liuxinyang1984/openscad/readme.md

1. 对丝的对接厚度
    > 商家:长度是40mm,中间厚度为8mm
    > 考虑对接,我们按照10mm设计
2.三通的对接长度,如10cm+三通+10cm 对接起来的长度是多少?
    > 商家: 三通两头长度 52mm,单头26mm
    > 对接螺纹按10mm设计,所有三通出通,单头要留16mm
    > 两根100mmDN15,对接后长度应该为232mm
2. 确认桌子长宽高度
3. 确认电脑机箱高度是否合适
