liuxinyang1984/openscad/desk_iso.png

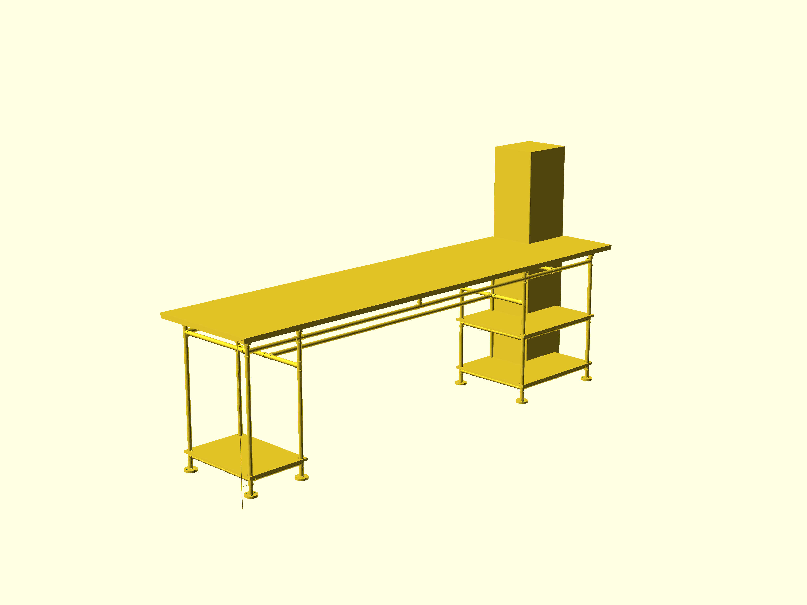
desk_iso.png
