liuxinyang1984/openscad/desk_iso_color.png

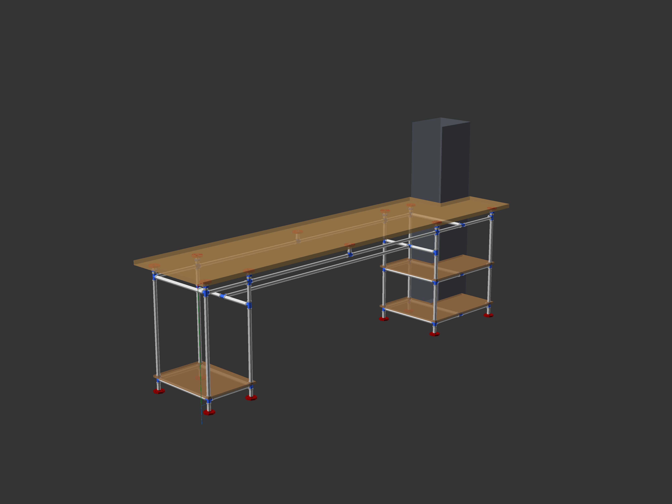
desk_iso_color.png
