liuxinyang1984/openscad/panel_plans.png

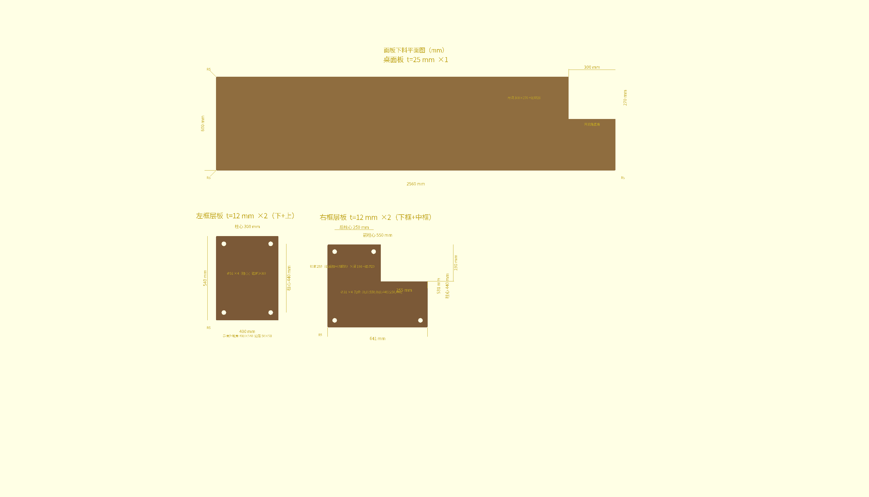
panel_plans.png
