liuxinyang1984/openscad/shelf_panel_plans.png

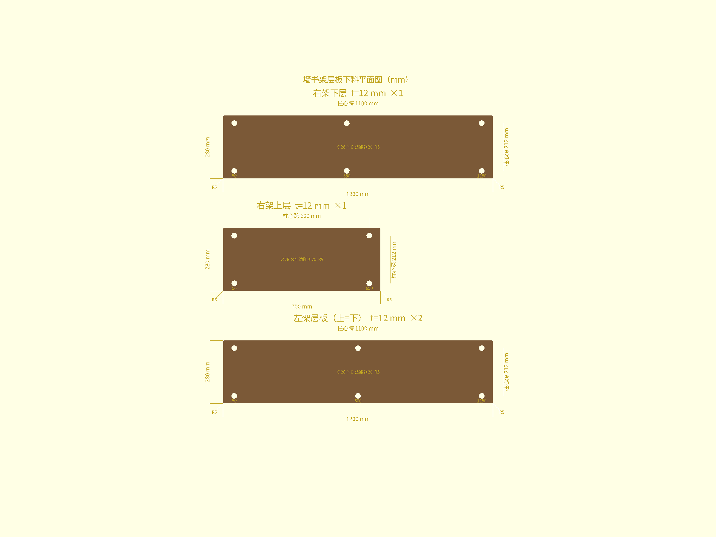
shelf_panel_plans.png
