liuxinyang1984/openscad/reference/pre-redesign/bom.md

# 桌架物料清单（BOM）

> 管件标准：**DN15**。  
> **直管下料均为整厘米（xxx0 mm）**：切断该长度后 **两端套丝**（按每端有效螺纹 14 mm 计，模型净直段 ≈ **下料 − 28**）。  
> **管件搭接（商家实测）**：三通/四通/五通主通 **52 mm**（单头 **26 mm**），螺纹拧入约 **10 mm** → 算净直段时每端占 **16 mm**（`fittingHeadExtraMm`）。

| 参数 | 值 |
|---|-----|
| 桌面总高 | **700** mm |
| **桌面左右宽** | **2000** mm |
| 桌深 | **700** mm |
| 单框柱心距 X | **284 mm**（横拉净 252 + 2×16） |
| 单框柱心距 Y | **594 mm**（纵拉净 562 + 2×16） |

参数源：`table_module.scad` 中 `rfCut*` / `lfCut*` / `deskCross*` / `fittingHeadExtraMm`。

---

## 总 BOM 汇总（右框 + 左框 + 左右拉结，1 桌）

### 连接件

| 序号 | 名称 | 规格 | 右框 | 左框 | **合计** |
|---|---|---|---|---|---|
| T-01 | 三孔内丝镀锌法兰 | DN15 | 8 | 8 | **16** + 拉结 **1** = **17** |
| T-02 | 立体四通 | DN15 | 8 | 10 | **18** |
| T-03 | 立体五通 | DN15 | — | 2 | **2** |
| T-04 | 平面三通 | DN15 | 3 | 3 | **6** + 拉结 **1** = **7** |
| T-05 | 对丝（成品，不切断） | DN15，长 40 | 4 | 4 | **8** + 拉结 **1** = **9** |

### 直管下料（全部 xxx0 mm）

| 序号 | 用途 | **下料** | 右框 | 左框 | 拉结 | **根数** | **下料小计 (mm)** |
|---|---|---|---|---|---|---|---|
| T-10 | 脚高短立管（四角） | **80** | 4 | 4 | — | **8** | 640 |
| T-11 | 下半框立管（下四通→上四通） | **220** | 4 | — | — | **4** | 880 |
| T-12 | 下半框立管（左框 z_hi 层） | **400** | — | 4 | — | **4** | 1600 |
| T-13 | 上半衔接短立管（右框四角） | **380** | 4 | — | — | **4** | 1520 |
| T-14 | 上半衔接短立管（左框反算） | **180** | — | 4 | — | **4** | 720 |
| T-15 | 前后横拉（沿 X） | **280** | 6 | 6 | — | **12** | 3360 |
| T-16 | 左右纵拉（沿 Y） | **590** | 6 | 6 | — | **12** | 7080 |
| T-17 | 缘垂挂下段（左/右缘） | **120** | 2 | 2 | — | **4** | 480 |
| T-18 | 缘深向半跨（左/右缘，反算） | **300** | 2 | 2 | — | **4** | 1200 |
| T-19 | 前拉结半管（前缘，中点对半） | **720** | — | — | **2** | 1440 |
| T-20 | 中/后拉结整管 | **1400** | — | — | **2** | 2800 |
| T-21 | 前拉结支口竖管（三通→法兰，@ z_top） | **50** | — | — | **1** | 50 |

| | |
|--|--|
| **直管总根数** | **61** |
| **直管下料总长** | **21770 mm（21.77 m）** |
| 法兰 T-01 | **17** |
| 平面三通 T-04 | **7** |
| 对丝 T-05 | **9** |
| 四通/五通 | **20** |

### 直管下料 → 模型净长（约）

| 下料 (mm) | 净直段 (mm) | 总根数 |
|---|---|---|
| 50 | 22 | 1 |
| 80 | 52 | 8 |
| 120 | 92 | 4 |
| 180 | 152 | 4 |
| 220 | 192 | 4 |
| 280 | 252 | 12 |
| 300 | 272 | 4 |
| 380 | 352 | 4 |
| 400 | 372 | 4 |
| 590 | 562 | 12 |
| 720 | 692 | 2 |
| 1400 | 1372 | 2 |

> **T-19 / T-21**：**前缘**横管 @ **z_top**（≈ **632 mm**，与柱顶五通/四通主通同高），中点三通 + 支口至桌面底。  
> **T-20（中）**：**deskCrossMidRowZMm**（≈ **552 mm**）**整根**拉结。 **T-20（后）**：**z_top** 整根。

---

## 右框架（1 套）

### 连接件

| 序号 | 名称 | 规格 | 数量 |
|---|---|---|---|
| R-01 | 三孔内丝镀锌法兰 | DN15 | 8 |
| R-02 | 立体四通 | DN15 | 8 |
| R-03 | 平面三通 | DN15 | 3 |
| R-04 | 对丝（成品） | DN15，长 40 | 4 |

### 直管下料（全部 xxx0 mm）

| 序号 | 用途 | **下料** | 数量 | 小计 (mm) |
|---|---|---|---|---|
| R-10 | 脚高短立管（四角） | **80** | 4 | 320 |
| R-11 | 下半框立管（下四通→上四通） | **220** | 4 | 880 |
| R-12 | 上半衔接短立管（四角） | **380** | 4 | 1520 |
| R-13 | 前后横拉（沿 X，z_lo / z_hi / 顶层） | **280** | 6 | 1680 |
| R-14 | 左右纵拉（沿 Y，z_lo / z_hi / 顶层） | **590** | 6 | 3540 |
| R-15 | 左缘垂挂下段 | **120** | 2 | 240 |
| R-16 | 左缘深向半跨（反算） | **300** | 2 | 600 |

**直管合计**：28 根，**8780 mm**（8.78 m，未含锯缝）。

| 下料 | 模型净直段（约） |
|---|---|
| 80 | 52 |
| 220 | 192 |
| 380 | 352 |
| 280 | 252 |
| 590 | 562 |
| 120 | 92 |
| 300 | 272 |

---

## 左框架（1 套）

> 相对右框：下部框 **z_hi 上圈四横管**抬高（`lfCutLowerShelfVertMm = 400`）；右前/右后顶托为 **五通**。

### 连接件

| 序号 | 名称 | 规格 | 数量 | 相对右框 |
|---|---|---|---|---|
| L-01 | 三孔内丝镀锌法兰 | DN15 | 8 | 同 R-01 |
| L-02 | 立体四通 | DN15 | 10 | 下框 8 + 顶 2 |
| L-03 | 立体五通 | DN15 | 2 | 右前/右后顶 |
| L-04 | 平面三通 | DN15 | 3 | 同 R-03 |
| L-05 | 对丝（成品） | DN15，长 40 | 4 | 同 R-04 |

### 直管下料（全部 xxx0 mm）

| 序号 | 用途 | **下料** | 数量 | 小计 (mm) | 右框对照 |
|---|---|---|---|---|---|
| L-10 | 脚高短立管（四角） | **80** | 4 | 320 | R-10 |
| L-11 | 下半框立管（撑 z_hi 四横管） | **400** | 4 | 1600 | R-11 **220** |
| L-12 | 上半衔接短立管（四角，反算） | **180** | 4 | 720 | R-12 **380** |
| L-13 | 前后横拉（沿 X） | **280** | 6 | 1680 | R-13 |
| L-14 | 左右纵拉（沿 Y） | **590** | 6 | 3540 | R-14 |
| L-15 | 右缘垂挂下段 | **120** | 2 | 240 | R-15 |
| L-16 | 右缘深向半跨（反算） | **300** | 2 | 600 | R-16 |

**直管合计**：28 根，**8700 mm**（8.70 m，未含锯缝）。

| 下料 | 模型净直段（约） |
|---|---|
| 80 | 52 |
| 400 | 372 |
| 180 | 152 |
| 280 | 252 |
| 590 | 562 |
| 120 | 92 |
| 300 | 272 |

> **L-12** 随 `lfCutLowerShelfVertMm` 与 `fittingHeadExtraMm` 反算；改 L-11 后请重开模型查 `lfCutStemMm`（须 xxx0）。

---

## 左右拉结（1 套）

> **前缘**：**z_top** 与左右柱顶 **五通** 主通同高，中点 **三通** + 支口 **直通 + 法兰 + 对丝**。  
> **中间**：**deskCrossMidRowZMm**（≈552 mm）**整根**。 **后缘**：**z_top** 整根。

### 连接件

| 序号 | 名称 | 规格 | 数量 |
|---|---|---|---|
| D-F1 | 平面三通 | DN15 | **1** |
| D-F2 | 三孔内丝镀锌法兰 | DN15 | **1** |
| D-F3 | 对丝（成品） | DN15，长 40 | **1** |

### 直管下料

| 序号 | 用途 | **下料** | 数量 | 小计 (mm) |
|---|---|---|---|---|
| D-10 | 前拉结半管（前缘） | **720** | 2 | 1440 |
| D-11 | 中/后拉结整管 | **1400** | 2 | 2800 |
| D-12 | 支口竖管（三通→法兰，@ z_top） | **50** | 1 | 50 |

改桌宽：调 **`table_width`**；`deskCrossHalfCutMm` / `deskCrossCutMm` 自动 xxx0。

---

## 分项合计（直管）

| 分项 | 根数 | 下料总长 (mm) |
|---|---|---|
| 右框架 | 28 | 8780 |
| 左框架 | 28 | 8700 |
| 左右拉结 | 5 | 4290 |
| **总 BOM** | **61** | **21770**（21.77 m） |

---

*生成依据：`table_module.scad`（前缘 **720**×2 + 支口 @ z_top；中 **1400** @ ≈552；后 **1400** @ z_top）。*
