liuxinyang1984/openscad/bom.md

# 物料清单（BOM）

> 按当前模型重算（桌子开口骨架 + 墙书架）。  
> 管件标准：**DN15**。  
> **搭接**：直管两端停在管件搭接外缘；净长 = 柱心距 − `2 × fittingHeadExtraMm`（16）。  
> **下料**：`ceil((净长 + 2 × threadEngageMm) / 10) × 10`（两端套丝各 10，整厘米 xx0）。  
> 参数源：`table/*`、`shelf/*`、`common/standards.scad`。

---

## 一、桌子（右框 + 左框 + 对接）

| 参数 | 值 |
|---|-----|
| 桌面板 | **2560 × 600 × 25** mm（右后开洞 300×270 + 过切 20；圆角 R5） |
| 骨架跨距 X | **2260** mm |
| 桌深 / 框深柱心 | **600** / **440** mm |
| 桌面底高 / 顶高 | **740** / **765** mm |
| 右框前跨 / 右移 / 底框高 | **550** / **300** / **350** mm |
| 左框宽 | **300** mm |
| `rf_z_lo` / `rf_z_hi` / `crossTieZ` | **86** / **350** / **542** mm |
| 左柜托板 | **400 × 540 × 12** mm ×2（孔边距 ≥30；孔径 ≈30.6；R5） |
| 右柜托板外包 | **≈641 × 531 × 12** mm ×2（右后切边自右后柱+outset≈45 起；同孔径/圆角） |

### 连接件

| 序号 | 名称 | 规格 | 右框 | 左框 | 对接 | **合计** |
|---|---|---|---|---|---|---|
| T-01 | 三孔内丝镀锌法兰 | DN15 | 8 | 8 | 1 | **17** |
| T-02 | 立体四通 | DN15 | 8 | — | — | **8** |
| T-03 | 平面三通 | DN15 | 3 | 9 | 1 | **13** |
| T-04 | 对丝 | DN15，长 40 | — | — | — | **0** |

> 底圈前缘已改为**整根**横管，无分叉三通。  
> 对接中点：**三通 + 短管 + 法兰**顶桌底（无对丝）。

### 直管下料（套丝前切断长度，xx0 mm）

| 序号 | 用途 | **下料** | 右 | 左 | 对接 | **根数** | 小计 (mm) |
|---|---|---|----|----|---|---|---|
| T-10 | 脚高短立管 | **80** | 4 | 4 | — | **8** | 640 |
| T-11 | 右框左缘：中框→拉结三通 | **180** | 2 | — | — | **2** | 360 |
| T-12 | 四柱垂挂上段→顶法兰（左右同长） | **200** | 2 | 4 | — | **6** | 1200 |
| T-13 | 缘深向半跨（左/右框朝桌心缘） | **210** | 2 | 2 | — | **4** | 840 |
| T-14 | 对接中托支口（三通→桌底法兰） | **210** | — | — | 1 | **1** | 210 |
| T-15 | 右框底圈后缘横拉 | **240** | 1 | — | — | **1** | 240 |
| T-16 | 右框中立管（下四通→中四通） | **260** | 4 | — | — | **4** | 1040 |
| T-17 | 左框底圈 X 横拉（前+后） | **290** | — | 2 | — | **2** | 580 |
| T-18 | 右框右缘上段→顶法兰 | **390** | 2 | — | — | **2** | 780 |
| T-19 | 左框左缘 crossTieZ 纵管 | **430** | — | 1 | — | **1** | 430 |
| T-20 | 左框四柱：底三通→拉结三通 | **450** | — | 4 | — | **4** | 1800 |
| T-21 | 右框底圈前缘整根 | **540** | 1 | — | — | **1** | 540 |
| T-22 | 对接半跨（柱↔中点三通）×2 | **770** | — | — | 2 | **2** | 1540 |

| | |
|--|--|
| **直管总根数** | **38** |
| **直管下料总长** | **10200 mm（10.20 m）**（未含锯缝） |

### 按下料长度汇总（桌）

| 下料 (mm) | 净直段（≈下料−20） | 根数 | 用途摘要 |
|---|---|---|---|
| 80 | 60 | 8 | 脚管 |
| 180 | 160 | 2 | 右框左缘垂挂下段 |
| 200 | 180 | 6 | 垂挂上段→法兰 |
| 210 | 190 | 5 | 缘半跨 ×4 + 对接中托 ×1 |
| 240 | 220 | 1 | 右框底后横 |
| 260 | 240 | 4 | 右框中立管 |
| 290 | 270 | 2 | 左框底 X |
| 390 | 370 | 2 | 右框右缘→法兰 |
| 430 | 410 | 1 | 左框左缘纵管 |
| 450 | 430 | 4 | 左框立柱下段 |
| 540 | 520 | 1 | 右框底前整根 |
| 770 | 750 | 2 | 对接半跨 |

### 木板（桌）

| 名称 | 厚度 | 数量 | 说明 |
|---|---|---|---|
| 桌面板 | 25 | 1 | 2560×600；右后开洞；三圆角 R5 |
| 左柜托板 | 12 | **2** | 外轮廓 **400×540**；∅≈30.6 孔×4；四角 R5 |
| 右柜托板 | 12 | **2** | 外包 ≈641×531；右后切宽≈255（柱+outset 起切）；同孔径/圆角 |

下料平面图：`panel_plans.svg` / `table/panel_plans.scad`。

### 右框架要点

- 底圈：前横**整根**（净 518 / 下料 540）+ 后横；**无左右纵管、无前缘分叉三通**
- 中圈 / 顶圈：无横纵管；中层板承在 `rf_z_hi` 立体四通
- 顶：立管 / 垂挂管直通翻法兰（无顶四通、无对丝）
- 左缘垂挂：半跨×2 + 中位三通（接对接）

### 左框架要点

- 底圈：仅前/后 X；底口均为三通
- `crossTieZ`：左缘整根 + 右缘半跨与中三通
- 托板 ×2：下 @ `lf_z_lo`，上 @ `crossTieZ`

### 对接要点

- 仅中位 @ `crossTieZ`：半跨 770×2 + 中托支口 210 + 三通 + 法兰
- 前/后顶层对接暂无

---

## 二、墙书架（右架 1200/700 + 左架 1200/1200）

| 参数 | 值 |
|---|-----|
| 层板深 / 厚 / 圆角 | **280** / **12** / **R5** |
| 格内净高 | **340** mm |
| 下层板顶 Z | **1565**（相对桌面顶 765 → 净空至板底 **788**） |
| 右架板长 | 下 **1200** / 上 **700** |
| 左架板长 | 上=下 **1200** ×2 |
| 层深管 | 净 **180** / 下料 **200**（整厘米取整） |
| 立管 | 净 **320** / 下料 **340** |
| 端柱上口 | **对丝 + 堵头**（已取消短管） |

> 当前模型侧框已装；柱间 X 向横拉管**尚未建模**（BOM 不含）。  
> 侧框几何以最右柱 `shelf_side_frame` 为基准 ×6（右 3 + 左 3）。

### 连接件（书架）

| 名称 | 规格 | 每柱 | ×6 | **合计** |
|---|---|---|-----|---|
| 三孔内丝镀锌法兰 | DN15 | 1 | 6 | **6** |
| 对丝 | DN15，长 40 | 3 | 6 | **18** |
| 平面四通（十字） | DN15 | 1 | 6 | **6** |
| 平面三通 | DN15 | 1 | 6 | **6** |
| 内丝堵头 | DN15 | 4 | 6 | **24** |

> 每柱对丝：墙锚 1 + 端柱上口前后各 1（**取代原短管**）。

### 直管下料（书架）

| 用途 | **下料** | 每柱 | ×6 | **根数** | 小计 (mm) |
|---|---|---|-----|---|---|
| 层深管（前后柱间） | **200** | 1 | 6 | **6** | 1200 |
| 立管（下堵头↔上接头） | **340** | 2 | 6 | **12** | 4080 |

| | |
|--|--|
| **直管总根数** | **18** |
| **直管下料总长** | **5280 mm（5.28 m）** |

### 木板（书架）

| 名称 | 尺寸 | 数量 | 孔 |
|---|---|---|-----|
| 右架下层 | **1200 × 280 × 12** | 1 | ∅≈26.3 ×6（三柱） |
| 右架上层 | **700 × 280 × 12** | 1 | ∅≈26.3 ×4（两柱） |
| 左架层板 | **1200 × 280 × 12** | 2 | ∅≈26.3 ×6（三柱居中） |

下料平面图：`shelf_panel_plans.svg` / `shelf/panel_plans.scad`。

---

## 三、合计速览

| | 桌 | 书架 | **场景合计** |
|--|----|---|---|
| 法兰 | 17 | 6 | **23** |
| 立体四通 | 8 | — | **8** |
| 平面四通 | — | 6 | **6** |
| 平面三通 | 13 | 6 | **19** |
| 对丝 | 0 | 18 | **18** |
| 堵头 | — | 24 | **24** |
| 直管根数 | 38 | 18 | **56** |
| 直管下料总长 | 10.20 m | 5.28 m | **15.48 m** |

> `TableBom.ods` 仍为旧导出，以本 `bom.md` 为准；需要时再刷电子表。
