liuxinyang1984/openscad/TableBom.ods

Sheet: 管材
桌子
序号 | 用途 | 下料 | 根数 | 小计 (mm)
T-10 | 脚高短立管 | 80 | 8 | 640
T-11 | 右框左缘：中框→拉结三通 | 180 | 2 | 360
T-12 | 四柱垂挂上段→顶法兰（左右同长） | 200 | 6 | 1200
T-13 | 缘深向半跨（左/右框朝桌心缘） | 210 | 4 | 840
T-14 | 对接中托支口（三通→桌底法兰） | 210 | 1 | 210
T-15 | 右框底圈后缘横拉 | 240 | 1 | 240
T-16 | 右框中立管（下四通→中四通） | 260 | 4 | 1040
T-17 | 左框底圈 X 横拉（前+后） | 290 | 2 | 580
T-18 | 右框右缘上段→顶法兰 | 390 | 2 | 780
T-19 | 左框左缘 crossTieZ 纵管 | 430 | 1 | 430
T-20 | 左框四柱：底三通→拉结三通 | 450 | 4 | 1800
T-21 | 右框底圈前缘整根 | 540 | 1 | 540
T-22 | 对接半跨（柱↔中点三通）×2 | 770 | 2 | 1540
合计 |  |  | 38 | 10200
书架
序号 | 用途 | 下料 | 根数 | 小计 (mm)
S-01 | 层深管（前后柱间） | 200 | 6 | 1200
S-02 | 立管（下堵头↔上接头） | 340 | 12 | 4080
合计 |  |  | 18 | 5280

Sheet: 管件
书桌
序号 | 名称 | 规格 | 合计
T-01 | 三孔内丝镀锌法兰 | DN15 | 17
T-02 | 立体四通 | DN15 | 8
T-03 | 平面三通 | DN15 | 13
T-04 | 对丝 | DN15 | 0
合计 | 38
书架
序号 | 名称 | 规格 | 合计
S-01 | 三孔内丝镀锌法兰 | DN15 | 6
S-02 | 对丝 | DN15 | 18
S-03 | 平面四通（十字） | DN15 | 6
S-04 | 平面三通 | DN15 | 6
S-05 | 内丝堵头 | DN15 | 24
合计 | 60
