liuxinyang1984/openscad/table_module.scad

// table_module.scad — 已迁移至 table/；请改 table/table_config.scad 与 table/main.scad
// main.scad 为唯一渲染入口

include <table/main.scad>
