liuxinyang1984/openscad/table/right_frame.scad

// table/right_frame.scad — 右框架几何
//
// 依赖：table_config.scad + standards.scad
// 坐标（局部）：原点对齐「未右移的左前网」；实际左柱在 x=rightFrameShiftX
//   左前/左后/右前立柱右移 rightFrameShiftX；右后立柱不移（躲开开洞立柱）
//   前缘在原右缘 x=rightFrameWidth 处用平面三通分出右侧纵管
//
// 直管起止约定：相对管件中心外偏 fittingHeadExtraMm，净长 = 中心距 − 2×fittingHeadExtraMm

module rf_pipe_z(length) {
    pipe(pipe_params, length);
}

module rf_pipe_x(length) {
    rotate([0, 90, 0])
        pipe(pipe_params, length);
}

module rf_pipe_y(length) {
    rotate([-90, 0, 0])
        pipe(pipe_params, length);
}

// -----------------------------------------------------------------------------
// 顶托：仅翻法兰（立管外丝直接拧入；承面 = frameHeight）
// -----------------------------------------------------------------------------

module rf_top_flange_only() {
    translate([0, 0, frameHeight])
        rotate([0, 180, 0])
            threaded_flange(flange_params);
}

// 旧：翻法兰 + 对丝（顶四通方案；保留备查）
module rf_top_flange_coupling() {
    translate([0, 0, frameHeight])
        rotate([0, 180, 0])
            threaded_flange(flange_params);
    pl_cz = frameHeight - flangeThicknessMm - couplingTotalMm / 2;
    difference() {
        translate([0, 0, pl_cz])
            pipe_link(pipe_params, couplingTotalMm, couplingHexMm);
        translate([0, 0, frameHeight])
            cylinder(r = 50, h = 20);
    }
}

// 垂挂直管：拉结三通上缘 → 顶翻法兰盘底（与左柜同长 lfHangToFlangeNetMm）
module rf_hang_pipe() {
    translate([0, 0, hangPipeStartZ])
        rf_pipe_z(lfHangToFlangeNetMm);
}

// -----------------------------------------------------------------------------
// 右缘立柱：底/中四通 → 上段直通翻法兰（无顶四通/对丝）
// -----------------------------------------------------------------------------

module rf_corner_post_right(rot_z) {
    mid_z = rf_z_lo + fittingHeadExtraMm;

    union() {
        threaded_flange(flange_params);

        translate([0, 0, flangeThicknessMm])
            rf_pipe_z(footPipeNetMm);

        translate([0, 0, rf_z_lo])
            rotate([0, 0, rot_z])
                fourway3d(pipe_params);

        translate([0, 0, mid_z])
            rf_pipe_z(rfMidPipeNetMm);

        translate([0, 0, rf_z_hi])
            rotate([0, 0, rot_z])
                fourway3d(pipe_params);

        translate([0, 0, rfStemStartZ])
            rf_pipe_z(rfStemNetMm);

        rf_top_flange_only();
    }
}

// -----------------------------------------------------------------------------
// 左缘立柱：底/中四通 → 垂挂三通 → 上段直通翻法兰（无顶平面四通/对丝）
// -----------------------------------------------------------------------------

module rf_corner_post_left(rot_z, hang_tee_rot_z = 0) {
    mid_z = rf_z_lo + fittingHeadExtraMm;
    stem_below_z = rf_z_hi + fittingHeadExtraMm;

    union() {
        threaded_flange(flange_params);

        translate([0, 0, flangeThicknessMm])
            rf_pipe_z(footPipeNetMm);

        translate([0, 0, rf_z_lo])
            rotate([0, 0, rot_z])
                fourway3d(pipe_params);

        translate([0, 0, mid_z])
            rf_pipe_z(rfMidPipeNetMm);

        translate([0, 0, rf_z_hi])
            rotate([0, 0, rot_z])
                fourway3d(pipe_params);

        translate([0, 0, stem_below_z])
            rf_pipe_z(rfStemBelowTieNetMm);

        translate([0, 0, crossTieZ])
            rotate([0, 0, hang_tee_rot_z])
                tee(pipe_params);

        rf_hang_pipe();

        rf_top_flange_only();
    }
}

// -----------------------------------------------------------------------------
// 前缘分叉三通：主通 ±X，支口 +Y（接原右缘纵管）
// -----------------------------------------------------------------------------

module rf_front_right_tee() {
    // 主通 ±X、支口沿 Y；相对初值绕 +X 翻 180°
    rotate([180, 0, 0])
        rotate([0, 0, 180])
            rotate([0, -90, 0])
                tee(pipe_params);
}

// -----------------------------------------------------------------------------
// 一层 XY：梯形 — 前缘可整根或三通分左右；后缘短横管；可选左右纵管
// -----------------------------------------------------------------------------

module rf_rail_layer_shifted(
    z,
    skip_left_y = false,
    skip_right_y = false,
    skip_front_right_x = false,
    skip_rear_x = false,
    skip_front_left_x = false,
    // 前缘整根（左前→右前，无分叉三通）；底圈无右侧纵管时用
    front_whole_x = false
) {
    sx = rightFrameShiftX;
    w = rightFrameWidth;
    d = rightFrameDepth;
    hx = fittingHeadExtraMm;

    if (front_whole_x) {
        // 前缘整根：左前柱(sx) → 右前柱(w+sx)，柱心距 = rightFrameWidth
        if (!skip_front_left_x)
            translate([sx + hx, 0, z])
                rf_pipe_x(rfSpanXNetMm);
    } else {
        // 前缘三通 @ 原右缘 x=w（未随右前柱右移）
        translate([w, 0, z])
            rf_front_right_tee();

        // 前缘左段：左前柱 → 三通
        if (!skip_front_left_x)
            translate([sx + hx, 0, z])
                rf_pipe_x(rfSpanXFrontLeftNetMm);

        // 前缘右段：三通 → 右前柱
        if (!skip_front_right_x)
            translate([w + hx, 0, z])
                rf_pipe_x(rfSpanXFrontRightNetMm);
    }

    // 后缘：左后柱 → 右后柱（右后不右移，跨距缩短）
    if (!skip_rear_x)
        translate([sx + hx, d, z])
            rf_pipe_x(rfSpanXRearNetMm);

    // 左侧纵管（顶层跳过，垂挂层另做）
    if (!skip_left_y)
        translate([sx, hx, z])
            rf_pipe_y(rfSpanYNetMm);

    // 右侧纵管：三通 → 右后柱（仍在 x=w）；整根前缘时不应开启
    if (!skip_right_y)
        translate([w, hx, z])
            rf_pipe_y(rfSpanYNetMm);
}

// -----------------------------------------------------------------------------
// 左缘深向垂挂（局部 x = rightFrameShiftX）
// -----------------------------------------------------------------------------

module rf_left_edge_depth_tie() {
    sx = rightFrameShiftX;
    y_mid = rightFrameDepth / 2;
    seg = rfEdgeHalfNetMm;
    hx = fittingHeadExtraMm;

    translate([sx, hx, crossTieZ])
        rf_pipe_y(seg);

    translate([sx, y_mid, crossTieZ])
        rotate([90, 0, 0])
            rotate([0, 0, 90])
                tee(pipe_params);

    translate([sx, y_mid + hx, crossTieZ])
        rf_pipe_y(seg);
}

// -----------------------------------------------------------------------------
// 总装
// -----------------------------------------------------------------------------

module table_right_frame() {
    sx = rightFrameShiftX;
    w = rightFrameWidth;
    d = rightFrameDepth;

    // 左前 / 右前（右移）；左后（右移）；右后（不移）
    translate([sx, 0, 0])
        rf_corner_post_left(180, 0);
    translate([w + sx, 0, 0])
        rf_corner_post_right(-90);
    translate([sx, d, 0])
        rotate([0, 0, 180])
            rf_corner_post_left(-90, 0);
    translate([w, d, 0])
        rotate([0, 0, 180])
            rf_corner_post_right(180);

    // 底圈：前后横管开口；前缘整根（无分叉三通）；左右缘纵管去掉
    rf_rail_layer_shifted(
        rf_z_lo,
        skip_left_y = true,
        skip_right_y = true,
        front_whole_x = true
    );
    // 中圈 / 顶圈：横纵管均去掉（上层板承在 rf_z_hi 立体四通 + 开孔）
    // rf_rail_layer_shifted(rf_z_hi, ...);
    // rf_rail_layer_shifted(rf_z_top, ...);

    rf_left_edge_depth_tie();

    e = fittingHeadExtraMm;
    assert(rfMidPipeNetMm > 0 && abs(rfMidPipeNetMm - (rf_z_hi - rf_z_lo - 2 * e)) < 0.01,
        "中立管搭接异常");
    assert(rfStemNetMm > 0
        && abs(rfStemNetMm - (frameHeight - flangeThicknessMm - rfStemStartZ)) < 0.01,
        "右缘上段→法兰搭接异常");
    assert(rfStemBelowTieNetMm > 0 && abs(rfStemBelowTieNetMm - (crossTieZ - rf_z_hi - 2 * e)) < 0.01,
        "左缘垂挂竖管搭接异常");
    assert(lfHangToFlangeNetMm > 0
        && abs(lfHangToFlangeNetMm - (frameHeight - flangeThicknessMm - hangPipeStartZ)) < 0.01,
        "左缘垂挂→法兰搭接异常");
    assert(rfSpanXNetMm > 0
        && abs(rfSpanXNetMm - (rightFrameWidth - 2 * e)) < 0.01,
        "底圈前缘整根横拉搭接异常");
    assert(rfSpanXFrontLeftNetMm > 0
        && abs(rfSpanXFrontLeftNetMm - (rightFrameWidth - rightFrameShiftX - 2 * e)) < 0.01,
        "前缘左段横拉搭接异常");
    assert(rfSpanXFrontRightNetMm > 0
        && abs(rfSpanXFrontRightNetMm - (rightFrameShiftX - 2 * e)) < 0.01,
        "前缘右段横拉搭接异常");
    assert(rfSpanXRearNetMm > 0
        && abs(rfSpanXRearNetMm - (rightFrameWidth - rightFrameShiftX - 2 * e)) < 0.01,
        "后缘横拉搭接异常");
    assert(rfSpanYNetMm > 0 && abs(rfSpanYNetMm - (rightFrameDepth - 2 * e)) < 0.01,
        "Y纵拉搭接异常");
    assert(rfEdgeHalfNetMm > 0 && abs(rfEdgeHalfNetMm - (rightFrameDepth / 2 - 2 * e)) < 0.01,
        "左缘半跨搭接异常");
    assert(footPipeNetMm > 0, "脚管净长异常");

    echo(str(
        "[右框梯形] shift=", sx,
        " 前跨=", rightFrameWidth, " 后跨=", rightFrameWidth - sx,
        " 底前整根净长=", rfSpanXNetMm,
        " 后横=", rfSpanXRearNetMm,
        " Y纵=", rfSpanYNetMm
    ));
}

module table_right_frame_in_place() {
    translate([rightFrameOriginX, rightFrameOriginY, 0])
        table_right_frame();
}
