liuxinyang1984/openscad/reference/pre-redesign/main_left.scad

// 仅预览左框架（独立入口）
include <table_module.scad>

table_left_frame_preview();
