liuxinyang1984/openscad/reference/pre-redesign/table.scad

// 桌子场景入口：在此 union 你在 table_module.scad 里写的模块
include <table_module.scad>
