liuxinyang1984/openscad/(list of files, cad)

Other CAD files:
reference/pre-redesign/config.scad
reference/pre-redesign/utils.scad
reference/pre-redesign/table/desk_cross.scad
reference/pre-redesign/table/left_frame.scad
reference/pre-redesign/table_module_legacy.scad
