liuxinyang1984/openscad/(commit log)

2025-11-06 删除局部精度
2025-11-06 修复删除局部精度引起的BUG
2025-11-06 新建模块
    [table.scad, table_module.scad, utils.scad]
2026-07-27 Rebuild desk project around table/ with a working right frame.
    Move the pre-redesign snapshot to reference/, centralize design sizes in table_config, and assemble the right frame (posts, rails, left-edge hang with coupling) using consistent fitting-edge pipe spans.
    [config.scad, desk_cross.scad, left_frame.scad, main.scad, main_left.scad, pipe_coupling_demo.scad, preview.scad, reference_lines.scad]
2026-07-27 Add single-layer left frame and planar fourway tops for desk cross.
    Left cage drops the mid rail layer; hang edges share crossTieZ, and both frames use a new planar cross fitting at the top for inter-frame pipes.
    [config.scad, left_frame.scad, main.scad, reference_lines.scad, right_frame.scad, standards.scad, table_config.scad, utils.scad]
2026-07-27 Finish desk assembly: cross ties, tabletop cutout, and updated envelope.
    Wire 100mm hang stems and inter-frame pipes with mid supports, drop the backup preview, and size the wood panel (with right overhang, cutout, and corner radii) independently of the frame span.
    [desk_cross.scad, left_frame.scad, main.scad, right_frame.scad, standards.scad, table_config.scad, tabletop.scad]
2026-07-27 Shift the right frame into a trapezoid to clear the rear cutout pillar.
    Move the left and front-right posts by 300mm, keep the rear-right post fixed, and split the front rail with tees to feed the old right-edge depth pipes.
    [right_frame.scad, standards.scad, table_config.scad]
2026-07-27 Add frame shelves: left rect, right rect with rear cutout like the tabletop.
    [main.scad, shelves.scad, table_config.scad]
2026-07-27 Add panel cut plans with dimensions and refresh the DN15 cut-length BOM.
    [panel_plans.scad, shelves.scad, tabletop.scad]
2026-07-27 Add exported BOM spreadsheet and desk/panel preview images.
    [TableBom.ods]
2026-09-24 基准：闭环组装修复前的完整场景快照。
    含公共 standards、书架、弯头/堵头/直接，以及桌板/书架渲染开关关闭，便于后续对照。
    [TableBom.ods, boards.scad, main.scad, shelf_config.scad, shelves.scad, standards.scad, utils.scad]
2026-09-24 修复封闭框架无法组装的BUG
    [boards.scad, desk_cross.scad, left_frame.scad, main.scad, right_frame.scad, shelf_config.scad, shelves.scad, standards.scad]
2026-09-24 修复右侧底部横管,修复板材开孔位置
    [boards.scad, panel_plans.scad, right_frame.scad, shelf_config.scad, shelves.scad]
2026-09-24 重新计算BOM
    [TableBom.ods, TableBom.xlsx, main.scad, shelf_config.scad]
